piit79/discipad/plate/discipad-plate.png

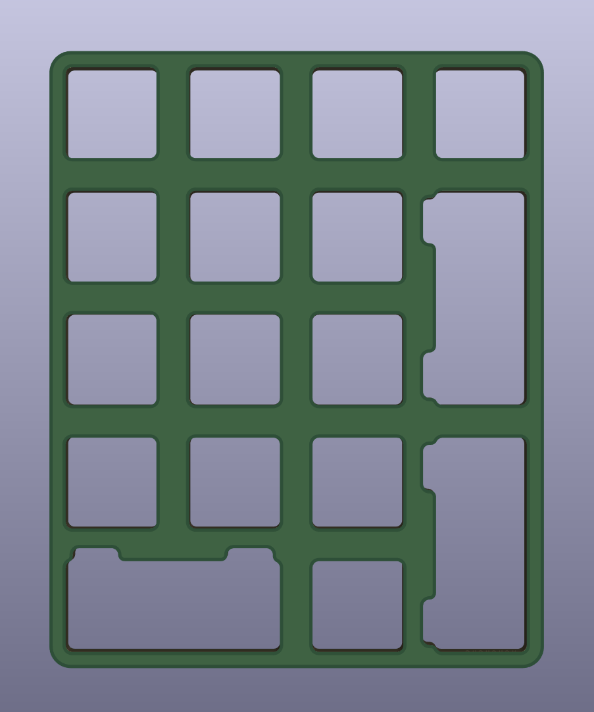
plate/discipad-plate.png
