piit79/discipad/doc/README.md

# DISCIPAD

[Build Guide](DISCIPAD_BUILD_GUIDE.pdf)

[QMK Toolbox Flashing Guide (Recommended)](DISCIPAD_FLASHING_GUIDE.pdf)

[Command Line Flashing Guide (Advanced)](DISCIPAD_FLASHING_GUIDE-COMMAND_LINE.pdf)

[Bootloader](./bootloader)

[BOM (Parts List)](https://octopart.com/bom-tool/zkOB9ZlB)

discipad
