piit79/discipad/pro/discipad-pro.png

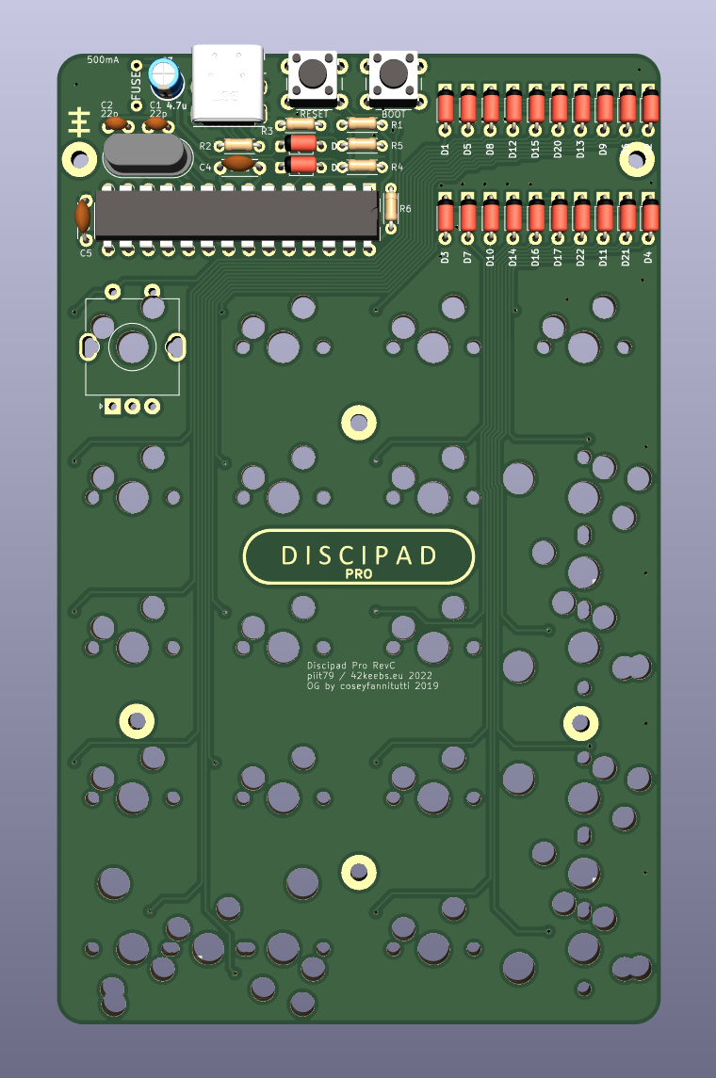
pro/discipad-pro.png
