piit79/discipad/(list of files, cad)

Other CAD files:
plate/discipad-plate.dxf
