piit79/discipad/pro/discipad-pro.kicad_pcb

## KiCad design pro/discipad-pro.kicad_pcb (2022-07-12)

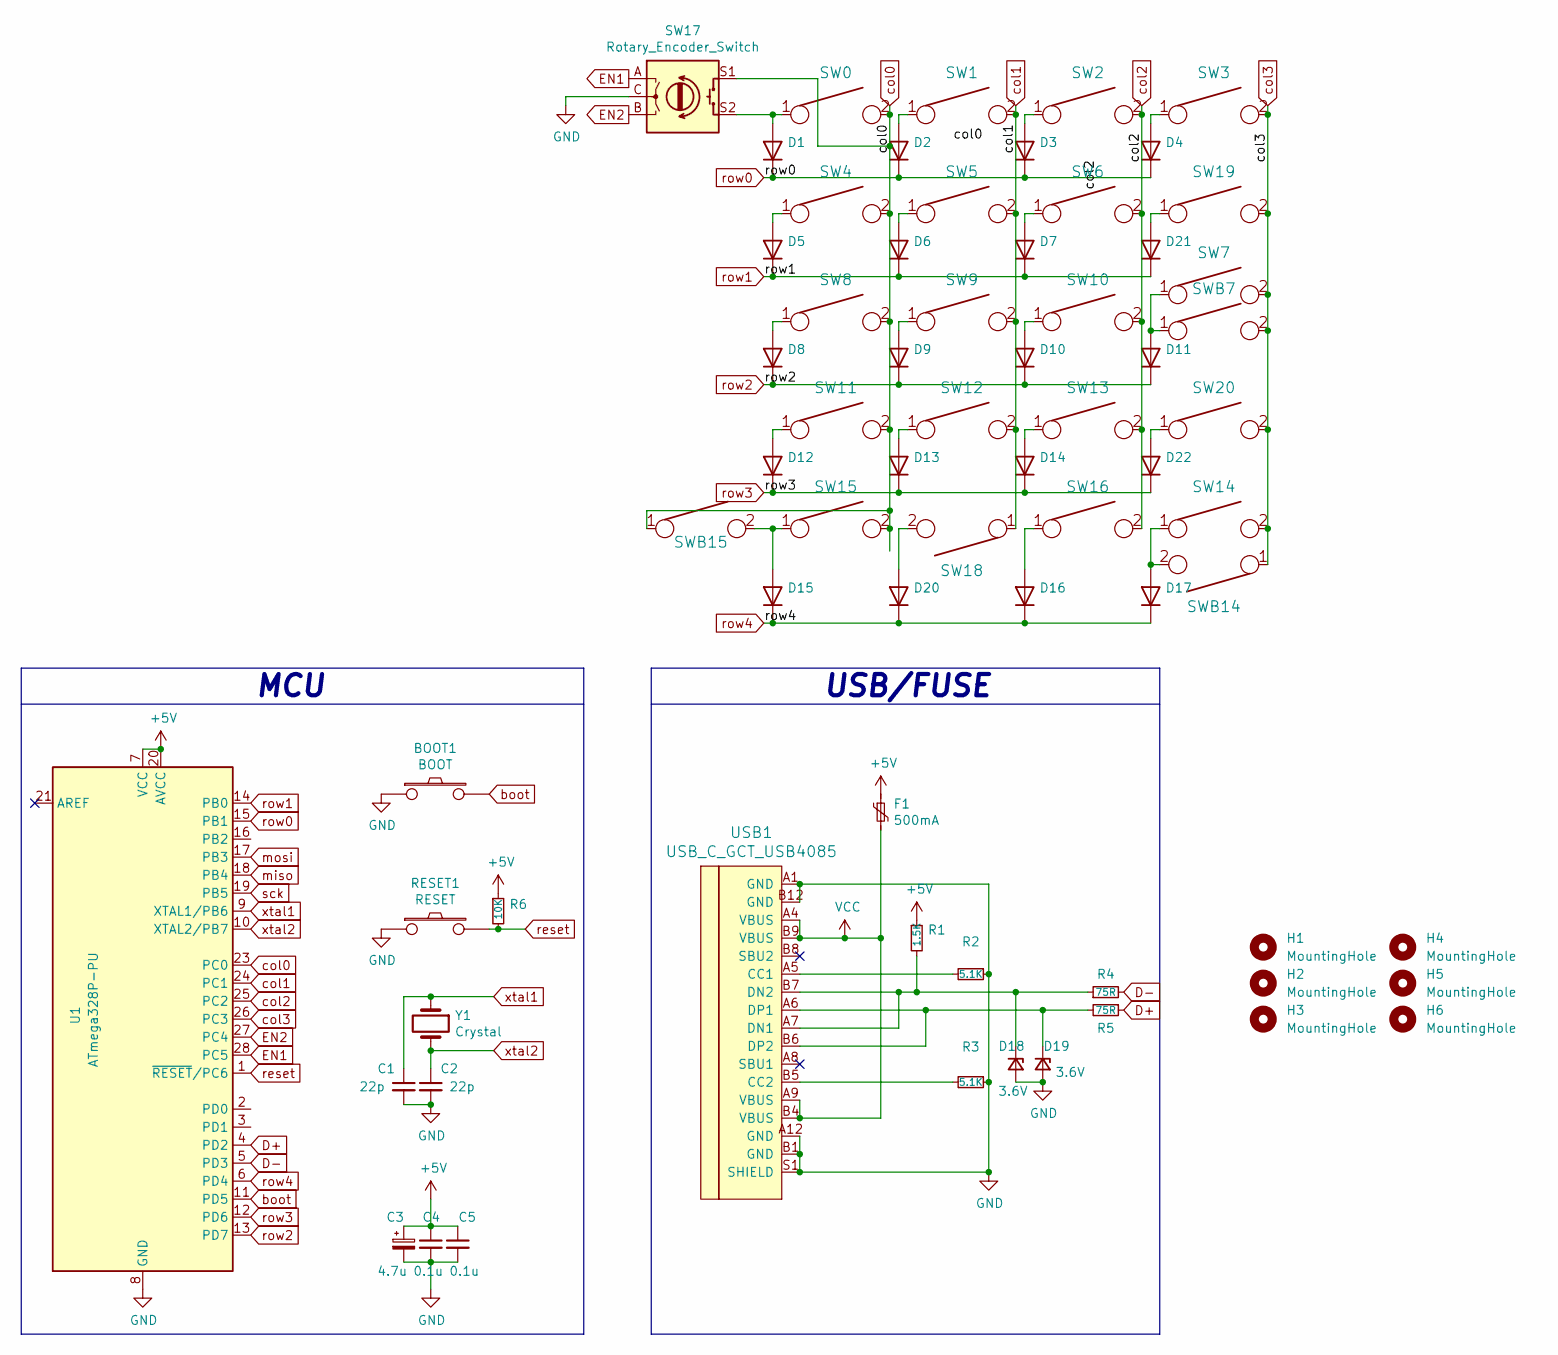
[picture p25: schematic discipad-pro.kicad_sch]

Parts:
BOOT1: BOOT; SW_PUSH_6mm
C1, C2: 22p; C_Disc_D3.0mm_W1.6mm_P2.50mm
C3: 4.7u; CP_Radial_D4.0mm_P1.50mm
C4, C5: 0.1u; C_Disc_D4.3mm_W1.9mm_P5.00mm
D1, D2, D3, D4, D5, D6, D7, D8, D9, D10, D11, D12, D13, D14, D15, D16, D17, D20, D21, D22: D_DO-35_SOD27_P5.08mm_Horizontal
D18, D19: 3.6V; ZD_DO-35_SOD27_P5.08mm_Horizontal_smaller
F1: 500mA; polyfuse_5.1mm
H1, H2, H3, H4, H5, H6: MountingHole; MountingHole_2.2mm_M2_Pad
R1: 1.5K; R_Axial_DIN0204_L3.6mm_D1.6mm_P5.08mm_Horizontal
R2, R3: 5.1K; R_Axial_DIN0204_L3.6mm_D1.6mm_P5.08mm_Horizontal
R4, R5: 75R; R_Axial_DIN0204_L3.6mm_D1.6mm_P5.08mm_Horizontal
R6: 10K; R_Axial_DIN0204_L3.6mm_D1.6mm_P5.08mm_Horizontal
RESET1: RESET; SW_PUSH_6mm
SW0, SW1, SW2, SW3, SW4, SW5, SW6, SW8, SW9, SW10, SW11, SW12, SW13, SW16, SW18, SW19, SW20: KEYSW; Kailh_MX_Socket-swapped-pads
SW7, SW14, SW15: KEYSW; Kailh_MX_Socket-2u-swapped-pads-reversed-stabilizer
SW17: Rotary_Encoder_Switch; RotaryEncoder_Alps_EC11E-Switch_Vertical_H20mm-for-MX
SWB7, SWB14, SWB15: KEYSW; Kailh_MX_Socket-swapped-pads
U1: ATmega328P-PU; DIP-28_W7.62mm
USB1: USB_C_GCT_USB4085; USB_C_GCT_USB4085-offset-pads
Y1: Crystal; Crystal_HC49-4H_Vertical

Connections:
+5V: C3.1, C4.1, C5.1, F1.1, R1.1, R6.1, U1.7 (VCC), U1.20 (AVCC)
D+: R5.1, U1.4 (PD2)
D-: R4.2, U1.5 (PD3)
EN1: SW17.A, U1.28 (PC5)
EN2: SW17.B, U1.27 (PC4)
GND: BOOT1.1, C1.2, C2.2, C3.2, C4.2, C5.2, D18.2 (A), D19.2 (A), R2.1, R3.1, RESET1.1, SW17.C, U1.8 (GND), U1.22 (GND), USB1.A1 (GND), USB1.A12 (GND), USB1.B1 (GND), USB1.B12 (GND), USB1.S1 (SHIELD)
unnamed: D1.2 (A), SW0.1, SW17.S2
unnamed: D2.2 (A), SW1.1
unnamed: D3.2 (A), SW2.1
unnamed: D4.2 (A), SW3.1
unnamed: D5.2 (A), SW4.1
unnamed: D6.2 (A), SW5.1
unnamed: D7.2 (A), SW6.1
unnamed: D8.2 (A), SW8.1
unnamed: D9.2 (A), SW9.1
unnamed: D10.2 (A), SW10.1
unnamed: D11.2 (A), SW7.1, SWB7.1
unnamed: D12.2 (A), SW11.1
unnamed: D13.2 (A), SW12.1
unnamed: D14.2 (A), SW13.1
unnamed: D15.2 (A), SW15.1, SWB15.2
unnamed: D16.2 (A), SW16.1
unnamed: D17.2 (A), SW14.1, SWB14.2
unnamed: D18.1 (K), R1.2, R4.1, USB1.A7 (DN1), USB1.B7 (DN2)
unnamed: D19.1 (K), R5.2, USB1.A6 (DP1), USB1.B6 (DP2)
unnamed: D20.2 (A), SW18.2
unnamed: D21.2 (A), SW19.1
unnamed: D22.2 (A), SW20.1
unnamed: R2.2, USB1.A5 (CC1)
unnamed: R3.2, USB1.B5 (CC2)
VCC: F1.2, USB1.A4 (VBUS), USB1.A9 (VBUS), USB1.B4 (VBUS), USB1.B9 (VBUS)
boot: BOOT1.2, U1.11 (PD5)
col0: SW0.2, SW4.2, SW8.2, SW11.2, SW15.2, SW17.S1, SWB15.1, U1.23 (PC0)
col1: SW1.2, SW5.2, SW9.2, SW12.2, SW18.1, U1.24 (PC1)
col2: SW2.2, SW6.2, SW10.2, SW13.2, SW16.2, U1.25 (PC2)
col3: SW3.2, SW7.2, SW14.2, SW19.2, SW20.2, SWB7.2, SWB14.1, U1.26 (PC3)
miso: U1.18 (PB4)
mosi: U1.17 (PB3)
reset: R6.2, RESET1.2, U1.1 (~RESET/PC6)
row0: D1.1 (K), D2.1 (K), D3.1 (K), D4.1 (K), U1.15 (PB1)
row1: D5.1 (K), D6.1 (K), D7.1 (K), D21.1 (K), U1.14 (PB0)
row2: D8.1 (K), D9.1 (K), D10.1 (K), D11.1 (K), U1.13 (PD7)
row3: D12.1 (K), D13.1 (K), D14.1 (K), D22.1 (K), U1.12 (PD6)
row4: D15.1 (K), D16.1 (K), D17.1 (K), D20.1 (K), U1.6 (PD4)
sck: U1.19 (PB5)
xtal1: C1.1, U1.9 (XTAL1/PB6), Y1.1
xtal2: C2.1, U1.10 (XTAL2/PB7), Y1.2

Notes on the sheet:
USB/FUSE
MCU

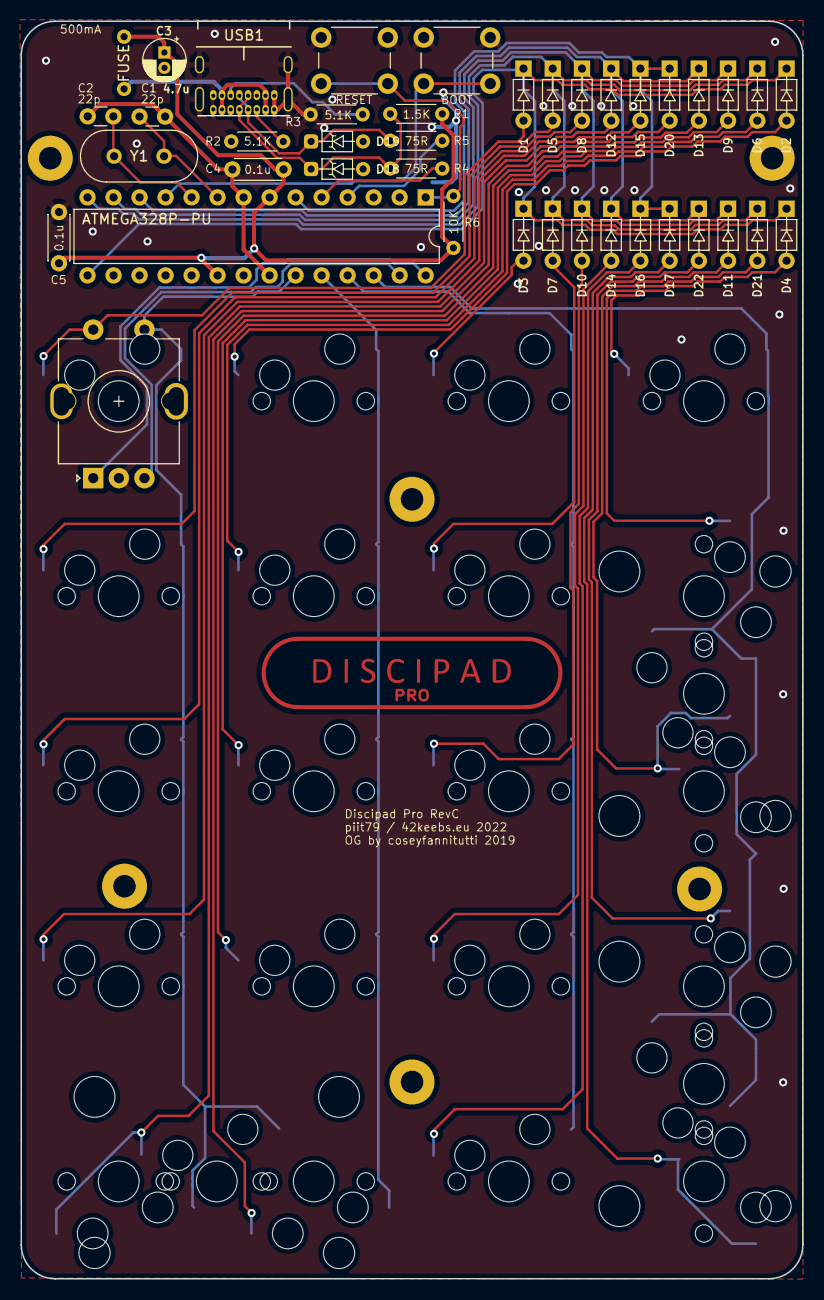
[picture p26: board discipad-pro.kicad_pcb from above]

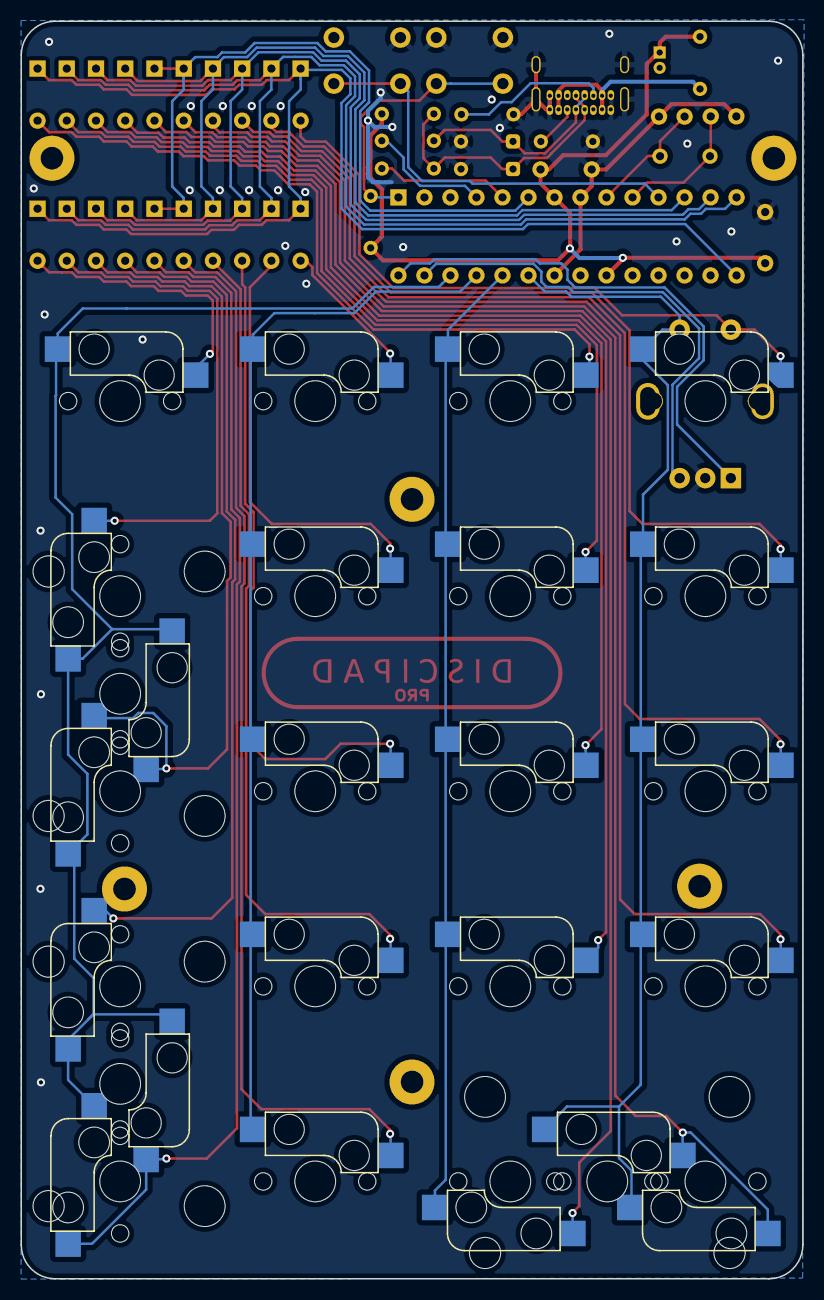
[picture p27: board discipad-pro.kicad_pcb from below]

Board: 2 copper layers, 76.3 x 122.8 mm, 69 parts (23 on the bottom side), 44 nets.
