piit79/discipad/(commit log)

2021-03-29 Add switch plate
    [discipad-plate.kicad_pcb]
2021-03-29 Add Discipad Pro with Kailh hostswap sockets
    [discipad-pro.kicad_pcb, discipad-pro.sch]
2021-03-29 Update gerber files and zips
    [discipad-bottom-B_Cu.gbr, discipad-bottom-B_Mask.gbr, discipad-bottom-B_Paste.gbr, discipad-bottom-B_SilkS.gbr, discipad-bottom-Edge_Cuts.gbr, discipad-bottom-F_Cu.gbr, discipad-bottom-F_Mask.gbr, discipad-bottom-F_Paste.gbr]
2021-10-17 Remove schematic/PCB backups; add .gitignore
2021-10-17 Add rotary encoder support to Discipad Pro
    [discipad-pro-B_Cu.gbl, discipad-pro-B_Mask.gbs, discipad-pro-B_Paste.gbp, discipad-pro-B_SilkS.gbo, discipad-pro-B_SilkS.gbr, discipad-pro-Edge_Cuts.gm1, discipad-pro-F_Cu.gtl, discipad-pro-F_Mask.gbr]
2021-10-17 Update bottom with plated logo and JLCPCB order placeholder
    [discipad-bottom-B_Mask.gbr, discipad-bottom-B_Paste.gbr, discipad-bottom-B_SilkS.gbr, discipad-bottom-F_Mask.gbr, discipad-bottom-F_Paste.gbr, discipad-bottom-F_SilkS.gbr, discipad-bottom-pcb-B_Cu.gbl, discipad-bottom-pcb-B_Mask.gbs]
2021-10-17 Update plate with JLCPCB order placeholder
    [discipad-plate-B_Cu.gbl, discipad-plate-B_Mask.gbr, discipad-plate-B_Mask.gbs, discipad-plate-B_Paste.gbp, discipad-plate-B_Paste.gbr, discipad-plate-B_SilkS.gbo, discipad-plate-B_SilkS.gbr, discipad-plate-Edge_Cuts.gm1]
2022-07-12 Add support for splitting all 2u keys; improve ground connection
    [discipad-pro.kicad_pcb, discipad-pro.kicad_sch, discipad-pro.sch]
2022-07-12 Add 42. Keebs KiCad library as submodule
2022-07-12 Switch to USB-C and diode footprints from the 42. Keebs library
    [discipad-pro.kicad_pcb, discipad-pro.kicad_sch]
2022-07-12 Plate RevC: update with split 2u keys
    [discipad-plate.dxf, discipad-plate.kicad_pcb]
2022-07-12 Bottom RevC: move cone feet holes further apart for better stability
    [discipad-bottom-pcb.kicad_pcb, discipad-bottom-pcb.sch]
2022-07-12 Remove Gerber files from the repository and add them to .gitignore
    Gerbers belong to GitHub releases
    [discipad-bottom-pcb-B_Cu.gbl, discipad-bottom-pcb-B_Mask.gbs, discipad-bottom-pcb-B_Paste.gbp, discipad-bottom-pcb-B_SilkS.gbo, discipad-bottom-pcb-Edge_Cuts.gm1, discipad-bottom-pcb-F_Cu.gtl, discipad-bottom-pcb-F_Mask.gts, discipad-bottom-pcb-F_Paste.gtp]
